philippedc/Li-ion-LifePo4-BMS-charger-tester-for-Arduino-Uno/cover_picture.jpg

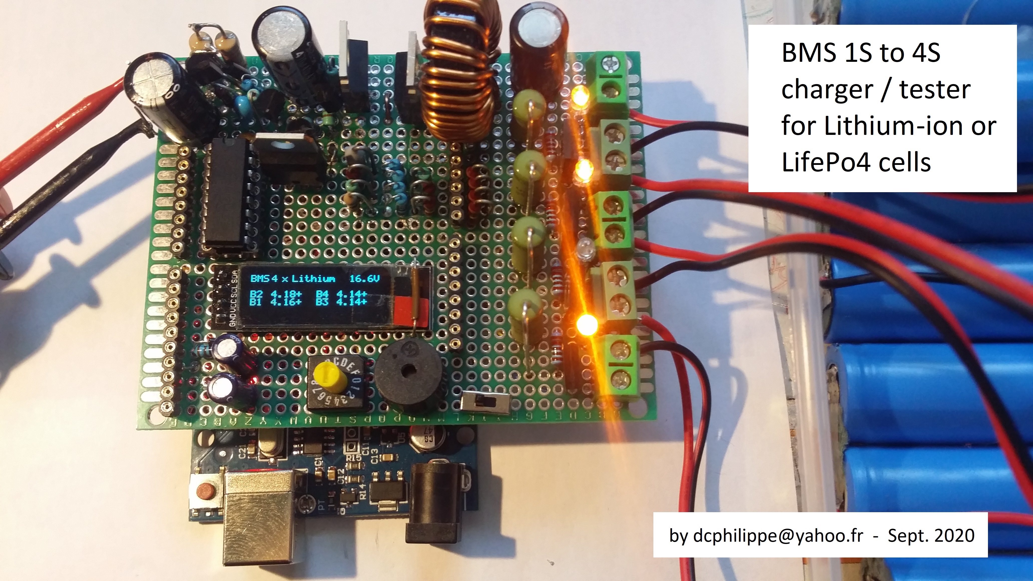
cover_picture.jpg
