philippedc/Li-ion-LifePo4-BMS-charger-tester-for-Arduino-Uno/BMS_circuit_diagram.JPG

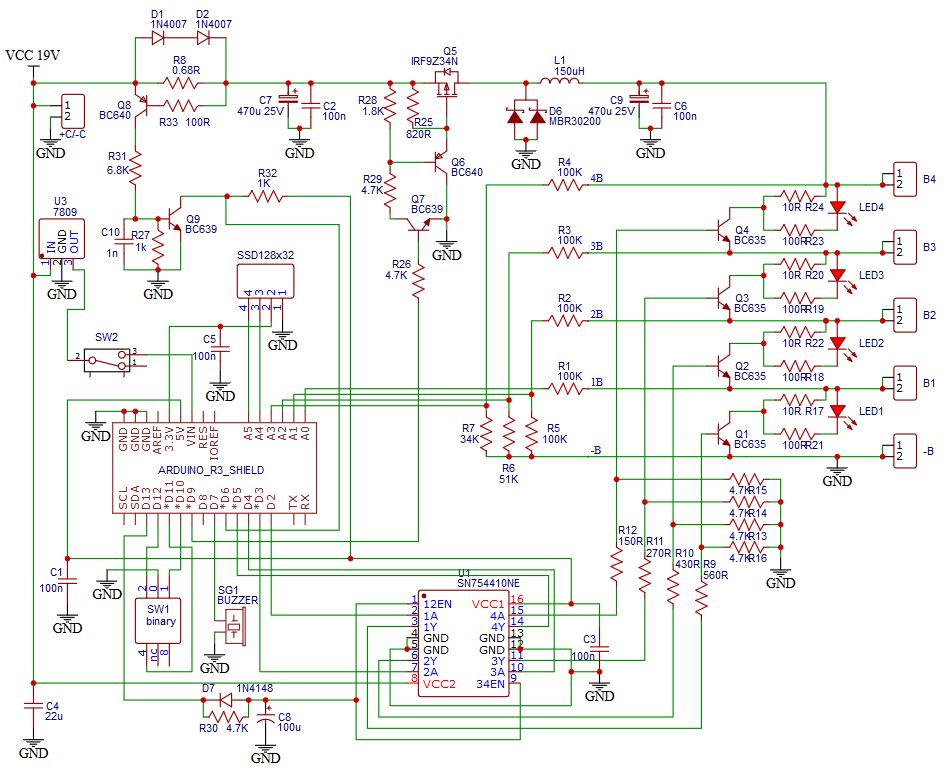
BMS_circuit_diagram.JPG
